Mr-What/Sleipnir/README.md

# Sleipnir
Designs and optimization for 8-legged horse style configuration of Jansen walking linkages

has code and drawings for building chassis for 3D printer or Laser cut.
Also has software used to optimize the Jansen walking linkage for use in the 8-legged horse (Sleipnir) style configuration
