Mr-What/Sleipnir/Drawings/linkage.scad

// for testing and development
//BarHeight=3;LinkRad=3;rad4=1.4;
//include <util.scad>


// test cases
//crankArm(17.5,4.1,4.82,1.48,5.6,4.82,1.48); // for config e
//linkage(44,4,5,1.5,6,5,1.5);
//linkage1(40.36, 10.725, 4.9, 2.7, 2.6, 4.1, 1.5); // BH for e
//monoBracedLinkage(40);Drad=2.4;Frad=7;//ForkHeight=4.3;
//brace(80,8,2.4);

module crankArm(len,h0,r0,d0,h1,r1,d1) difference() {
  linkage(len,h0,r0,d0,h1,r1,d1,sr0=.05,sr1=.2,ar0=.9,ar1=1.4);

  //// add little hole for "cotter-wire" on crank arm
  //translate([0,0,h0/2]) rotate(a=[90,0,0])
  //   cylinder(h=3*r0,r=.8,$fn=80,center=true);

  // for change to using standoffs as axle, counter sink axle screw
  translate([0,0,h0-1.5]) cylinder(h=2.2,r1=rad4,r2=3.3,$fn=24);

  // try another countersink for spindle screw.
  translate([len,0,-0.7]) cylinder(h=2.2,r1=3.3,r2=rad4,$fn=24);
}



// for very short linkages.  Just end nodes, no T bar.
module linkage(len,h0=5,r0=3,d0=1.5,h1=5,r1=3,d1=1.5,
               sr0=-.2,sr1=-.2,ar0=1.2,ar1=1.2) {
echo(str("linkage:",len,",",h0,",",r0,",",d0,",",h1,",",r1,",",d1));
//%linkage(len,h0,r0,d0,h1,r1,d1);

difference() {
  union() {
    translate([len,0,0]) 
       linkNode(r1,h1,ar1,sr1,dx=-3*r1);
       linkNode(r0,h0,ar0,sr0,dx= 3*r0);

    blade([len,0,0.4],3.4,2,    // bar bottom
          [ 0 ,0,0.4],3.4,2);

    blade([len-r1,0,2],1,h1-2.5,   // vertical brace blade
          [    r0,0,2],1,h0-2.5,fn=17);
  }
  drillHole(d0);
  translate([len,0,0]) drillHole(d1);

  translate([-10,-10,-10]) cube([20+len,20,10]);
}}

module monoBracedLinkage(len) difference() {
  union() { //------------------------ EF
    blade([ 0 ,0,0.3],Frad+.3, 2 ,
          [len,0,0.3], 2.5   ,1.6,fn=64);

    // non-braced (BED side) reinforcement 
    translate([len,0,0]) linkNode(Drad+1,4,ar=1.6,dx=-5*Drad);

    linkNode(5,4,ar=.7,off=-.2,dx=2*Frad,dz=2);

    // out-of-plane ridge/brace
    blade([2    ,0,1  ],1,3,
          [len-3,0,0.5],1,3,fn=16);
  }

  for(x=[0,len]) translate([x,0,0]) drillHole(rad4);
  translate([-20,-20,-20]) cube([len+40,40,20]);
}

module linkage2(len,h0,r0,d0,h1,r1,d1) { difference() { union() {
   hull() { barAnchor(1.5*r0);
      cylinder(h=h0,r1=r0+.2,r2=r0-0.2,$fn=48); }
   translate([len,0,0]) { hull() { barAnchor(-1.5*r1);
      cylinder(h=h1,r1=r1,r2=0.4*r1+0.6*d1,$fn=48); }}
   hull() {                cylinder(h=BarHeight,r1=LinkRad+.2,r2=LinkRad-.2,$fn=6);
      translate([len,0,0]) cylinder(h=BarHeight,r1=LinkRad+.2,r2=LinkRad-.2,$fn=6); }
   hull() {                   cylinder(h=h0-0.5,r1=2,r2=.6,$fn=6);
      translate([len-d1,0,0]) cylinder(h=h1-0.5,r1=2,r2=.6,$fn=6); }
   }
   drillHole(d0);
   translate([len,0,0]) drillHole(d1);
}}

module linkage1(len,h0,r0,d0,h1,r1,d1) difference() {
echo("linkage1",len,h0,r0,d0,h1,r1,d1);
  union() {
    translate([len,0,0])
      linkNode(r1,h1,0.6,-.2,dx= -4*r1);
      linkNode(r0,h0,2.6,-.2,dx=2.5*r0);

    blade([ 0 ,0,.4], r0-.2,2.4,
          [len,0,.4],d1+1.5,1.8  );
    
    blade([    d0,0,2],1 ,h0-2,
          [len-r1,0,0],1,BarHeight-.5,fn=17);
  }

  drillHole(d0);
  translate([len,0,0]) drillHole(d1);
  translate([-10,-10,-10]) cube([len+20,20,10]);
}

/*

module brace1(len,h0,r0) {
r1=r0+1.7;
difference() {
  union() {
    difference() { hull() { cylinder(h=3,r1=r1+.1,r2=r1-.1,$fn=48);
      translate([len,0,0]) cylinder(h=3,r1=r1+.1,r2=r1-.1,$fn=48); }
      translate([1.5,0,-1.5]) hull() { cylinder(h=3,r1=r1-1.6,r2=r1-1.4,$fn=6);
             translate([len-1.5,0,0])  cylinder(h=3,r1=r1-1.6,r2=r1-1.4,$fn=6); }}

   translate([len,0,0])
   hull() { cylinder(h=h0,r1=r1+.2,r2=r1-.1,$fn=48);
      translate([-r1-4,0,2]) sphere(r=1,$fn=12); }
   hull() { cylinder(h=h0,r1=r1+.2,r2=r1-.1,$fn=48);
      translate([ r1+4,0,2]) sphere(r=1,$fn=12); }

   translate([0,0,h0/2]) hull() { scale([1,1,h0/2]) sphere(r=1,$fn=12);
            translate([len,0,0])  scale([1,1,h0/2]) sphere(r=1,$fn=12); }
   
   }
   drillHole(r0);
   translate([len,0,0]) drillHole(r0);
}}

*/

module brace(len,h0,r0) difference() {
  union() {
    blade([ len/2,0,.6],r0+2,1.8,
          [-len/2,0,.6],r0+2,1.8);

    for(x=[-1,1]) translate([x*len/2,0,0])
       linkNode(r0+2,h0,ar=0.7*h0/r0,dx=-x*h0*1.5);

     blade([ len/2,0,0],1.6,h0-.3,
           [-len/2,0,0],1.6,h0-.3);
   }

   for(x=[-1,1]) translate([x*len/2,0,0]) drillHole(r0);

   translate([0,0,-5]) cube([len+20,20,10],center=true);
}
