Mr-What/Sleipnir/Drawings/steel/walkerChassis.scad

// config e
Ay=3.318;
AC=17.5;
Bx=53.83;

loY=-60;  // location of lower brace beams
loX= 10;

zBar=90;

$fn=8;

// meter stick for scale
%translate([65,-42,0]) cube([5,100,5],center=true);
%translate([65,0,0]) difference(){
  cube([5,5,140],center=true);
  cube([6,6, 40],center=true);
}

for (a=[-1,1]) {
  %translate([0,0,(zBar-10)*a]) legProxy();
  %translate([0,0,(zBar+10)*a]) legProxy();
  translate( [0,0, zBar    *a]) color([.2,.2,.8,1]) mainBar();
  #translate([0,0,a*(zBar+20)]) rotate([0,90*(a+1),0]) outerCap();
}
basket();

module basket() {
  for(a=[-1,1]) {
    *translate([Bx*a,0,0]) cylinder(r=1,h=120,$fn=16,center=true); // main axle
    for (b=[-1,1]) translate([Bx*b,0,zBar*a]) {
       color([0,0,1,.6]) translate([0,0,-6*a])
       cylinder(r=1.9,h=60,$fn=16,center=true); // axle

       // axle brace sleves
       translate([0,0,-26*a]) cylinder(r=2.5,h=18,$fn=16,center=true);
    }

    //color([.6,.8,0,1]) 
    translate([loX*a,loY,0]) difference() { 
       cube([2.5,2.5,230],center=true); // lower rails

       // remove center section for wide platform version
       cube([3,3,78.5],center=true);
    }

    hull() for (b=[-1,1]) translate([ Bx*b, 0 ,71*a]) sphere(1); // arm guard bar
    //hull() for (b=[-1,1]) translate([loX*b,loY,71*a]) sphere(1); // outer foot bar
    for (b=[-1,1]) {
      hull() { // outer diagonal
        translate([ Bx*b, 0  ,70*a]) sphere(1);
        translate([20*b,loY+2,70*a]) sphere(1);
      }
    }

    for(x=[-1,1]) {
       hull() { // inner back trap
         translate([x*36    ,loY+2,28*a]) sphere(1);
         translate([x*(Bx+1),  1  , 5*a]) sphere(1);
       }
       hull() { // outer back
         translate([x*36,loY+1,40*a]) sphere(1);
         translate([x*Bx,  0  ,60*a]) sphere(1);
       }
    }

    // may do something more complicated for payload bay,
    // but for now, just stich sides together
    translate([a*(Bx+1),1,0]) difference() {
       cube([3.8,3.8,140],center=true);
       translate([-.5*a,-.5,0]) cube([3.8,3.8,141],center=true);
    }

    translate([34*a,loY+2.7,0]) difference() {
       cube([2.5,2.5,138],center=true);
       translate([-.4*a,.4,0]) cube([2.5,2.5,139],center=true);
    }
    translate([0,loY+3,67*a]) rotate([0,90*(a+1),0]) difference() {
       cube([70,3.8,3.8],center=true);
       translate([0,.4,.4]) cube([72,3.8 ,3.8],center=true);
    }
    hull() {  // central floor cross
      translate([ 34*a,loY+1, 38]) sphere(1);
      translate([-34*a,loY+1,-38]) sphere(1);
    }
  }

  //for(z=[-1,0,1])
  for(z=[-1,1])
  translate([0,loY+.4,40*z]) rotate([0,(z==1)?180:0,0]) difference() {
     cube([70,2.5,2.5],center=true);
     translate([0,-.4,-.4]) cube([71,2.5,2.5],center=true);
  }
  translate([0,loY+2,0]) rotate([90,0,0]) cylinder(r=4,h=.4,$fn=32);
  color([0,.2,.8,.2]) // expanded mesh floor
     translate([0,loY+2,0]) cube([68,.5,134],center=true);
     //translate([0,loY+2,0]) cube([2*loX,1,130],center=true);
}

module mainBar() {
  cube([110,5,5],center=true);
  translate([0,Ay,0]) {
    cylinder(r=1.5,h=4,$fn=16,center=true);
    #cylinder(r=AC,h=2,$fn=36,center=true);
    //cylinder(r=AC+2,h=.4,$fn=36,center=true);
  }

  // lower support
  for(x=[-1,1]) {
     // lower rail tubes
     translate([x*loX,loY,0]) cube([3.8,3.8,10],center=true);

     hull() {     // diagonals
       translate([x*(loX+2),loY,0]) sphere(1);
       translate([x*(Bx-8),0,0]) sphere(1);
     }
  }
  translate([0,loY,0]) cube([2*loX,3.8,3.8],center=true);
}

module outerCap() {
  for (b=[-1,1]) translate([Bx*b,0,-1]) {
     // axle brace sleves... shorter on outside
     cylinder(r=2.5,h=6 ,$fn=16,center=true);
  }
  translate([0,loY,0]) cube([2*loX,3.8,3.8],center=true);
  for(x=[-1,1]) translate([x*loX,loY,1])
         cube([3.8,3.8,8],center=true); // lower rail sleves

  for (b=[-1,1]) hull() { // outside diagonal brace
    translate([loX*b,loY,0]) sphere(1);
    translate([ Bx*b, 0 ,0]) sphere(1);
  }
  hull() for(b=[-1,1]) translate([Bx*b,0,0]) sphere(1);
}

module legProxy() scale([1,1,12]) {
  legProxy1();
  mirror([1,0,0]) legProxy1();
}

// measurements from drawing, center pixel 600,300, 4 pixels/cm
module legProxy1() difference() {

  union() { hull() {
    translate([0,3.32,0]) cylinder(r=17.5+2,h=1,$fn=36,center=true);
    translate([-250/4, 290/4,0]) node();
    translate([-200/4, 290/4,0]) node();
    translate([-360/4, 120/4,0]) node();
    translate([-500/4,-110/4,0]) node();
    translate([-430/4,-230/4,0]) node();
  }
  hull() {
    translate([-400/4,-220/4  ,0]) node();
    translate([-340/4,-370/4+2,0]) node();
    translate([ -90/4,-370/4+2,0]) node();
    translate([-140/4,-120/4  ,0]) node();
  }}

  // cut out to show step height
  translate([-50,-92+5,-1]) cube([3,17.5-5,2]);
}

module node() cylinder(r=2,h=1,$fn=9,center=true);
