Mr-What/Sleipnir/(list of files, cad)

Other CAD files:
Drawings/JansenAssembly.scad
