Mr-What/Sleipnir/(commit log)

2015-09-08 re-building from old SVN repo
    [Jansen.scad, JansenBED.scad, JansenDefs.scad, JansenFoot.scad, JansenMain.scad, Klann.scad, basketMount.scad, driveElectronicsMount.scad]
2015-09-10 reduce fuzz for spread around holes. current printer does not spread that much
    [Jansen.scad]
2015-09-10 beef up support for printability under cura
    [JansenBED.scad]
2015-09-10 tighten up for newer, lower spread printer
    [motorMount.scad]
2015-09-17 make B node on BH a little thicker. Want to get leg assembles a little farther from main bar
    [Jansen.scad]
2015-09-17 more bracing at fork
    [JansenBED.scad]
2015-09-17 make support wall a little thicker for cura
    [JansenFoot.scad]
2015-09-17 made L298N module mounts a little closer to walls. raise top platform a bit to clear L298N heatsink
    [driveElectronicsMount.scad]
2015-09-28 added (optional) cuts to fit motor gear onto "bobbin" hub
2015-09-29 make small end of BH a little thinner, to allow nylock to lock using 1 inch screw for H node.
    [Jansen.scad]
2015-09-29 seems to work OK on kebab skewers. might need larger for proper 3/16" diameter rod or tube
    [pinchCap.scad]
2015-12-02 tried to make H node a bit thinner. Also trying to bring legs in a little closer to main bar to save width
    [Jansen.scad]
2015-12-02 added motor group demo display. made main drive pulley larger, but with pass-through for crank-arm screw
    [Jansen.scad, pulley.scad]
2015-12-03 initial design. checking in before changing a bit
    [payloadMount.scad]
2015-12-03 added platform and mounting tabs
    [payloadMount.scad]
2015-12-03 tweaking platform mount
    [payloadMount.scad]
2015-12-03 more mount tweaks
    [payloadMount.scad]
2015-12-03 checking in before making tabs a bit bigger
    [payloadMount.scad]
2015-12-03 larger platform tabs, with pilot holes for optional screws
    [payloadMount.scad]
2015-12-04 liked snap-on upper platform so much, changed lower to use a similar platform
    [payloadMount.scad]
2015-12-04 recess lower tabs a bit
    [payloadMount.scad]
2015-12-04 make moving connections to B axles a little looser
    [Jansen.scad, JansenBED.scad, JansenMain.scad]
2015-12-06 made B node on BH a little fatter
    [Jansen.scad]
2015-12-06 moved link up a bit from foot to make a bit of an ankle
    [JansenFoot.scad]
2015-12-08 made lit a bit bigger, with more rounded corners
    [payloadMount.scad]
2015-12-10 adding x pegs. check in before altering a bit
    [payloadMount.scad]
2016-01-02 more details, and split main assembly instructions to 3D folder
2016-01-02 draft for revision of 3D printed version instructions
2016-01-02 moved motor down 1cm. belts could have been tighter
    [motorMount.scad]
2016-01-03 made motor pulley a little "rough" to act like teeth. It has had trouble slipping on the belt
    [Jansen.scad, pulley.scad]
2016-01-03 reduce seperation on main brace
    [JansenMain.scad]
2016-01-03 rounded corners on some parts
    [Jansen.scad]
2016-01-03 seperated out some modules. rounded edges on crankLink
    [Jansen.scad, crankLink.scad, linkage.scad]
2016-01-05 put some useful small modules in an easier file to include
    [util.scad]
2016-01-06 rounding edges
    [Jansen.scad, crankLink.scad, linkage.scad, util.scad]
2016-01-06 rounded more pieces. especially BED
    [Jansen.scad, JansenBED.scad, linkage.scad, util.scad]
2016-01-08 changes to main bar bracing. try to make it stiffer
    [JansenMain.scad, motorMount.scad]
2016-01-08 more clearance for new main bar bracing blades
    [motorMount.scad]
2016-01-09 checking fit of main-bar connectors
    [Jansen.scad, JansenMain.scad]
2016-01-09 beefed up rails. DE was a bit flexy
    [JansenBED.scad]
2016-04-11 draft for support structure in steel version
    [walkerChassis.scad]
2016-04-11 checking in before changing to have braces under main bar
    [walkerChassis.scad]
2016-04-11 completed first version of 5 part assembly
    [walkerChassis.scad]
2016-04-11 added color coding on assemblies
    [walkerChassis.scad]
2016-04-11 convert to actual angle beams for floor frame
    [walkerChassis.scad]
2016-04-17 notional drawing for leg assembly in steel. has kinematic solution
2016-04-18 corrected kinematics
    [legAssembly.scad]
2016-04-18 minor bug fixes and details.
    [legAssembly.scad]
2016-04-18 change to use $t for animations
    [legAssembly.scad]
2016-04-23 minor tweaks
    [legAssembly.scad]
2016-04-25 added animation of full assembly
    [Jansen.scad]
2016-04-25 removed assembly code to another file
    [Jansen.scad, JansenAssembly.scad]
2016-06-12 checking in before making knee wider
    [legAssembly.scad]
2016-06-13 re-design for wider knee (F) joint
    [legAssembly.scad]
2016-07-25 changing to use mostly flanged bearings, and rod-end (heim) joints in progress...
    [legAssembly.scad, util.scad]
2016-07-25 more details on hinges, plans for bushing at axle
    [legAssembly.scad]
2016-07-26 improved CH clearance at H node on BH segments
    [legAssembly.scad]
2016-08-06 checking in before trying to mount 698 bearings on pedal spindle closer
    [legAssembly.scad, walkerChassis.scad]
2016-08-06 looks like old changes for rounder parts were never committed?
    [JansenFoot.scad, linkage.scad]
2016-08-06 older changes with move to rounder parts, never committed?
    [motorMount.scad, util.scad]
2016-08-06 months old changes, not committed?
    [payloadMount.scad]
2016-08-06 tweaked spacings around F698 bearings a bit.
    [legAssembly.scad]
2016-08-06 move to channelFork on hip
    [legAssembly.scad]
2016-08-09 proper drawings for 25x37x7 bearings on B-axle
    [legAssembly.scad]
2016-09-01 change to female Heim rod-ends, SI8 T/K, on a headless bolt. The females seem to be a little "beefier", and I think it will be easier to weld to cut-off bolts, than to weld or tap to tubes. We will b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
    [legAssembly.scad, util.scad]
2016-09-02 minor tweaks. check in before drawing bolted H fork on foot
    [legAssembly.scad, util.scad]
2016-09-03 try a square tube at Hamstring for foot triangle. This might be easier to fabricate
    [legAssembly.scad]
2016-09-03 going back to thin knee
    [legAssembly.scad]
2016-09-03 simplified build a bit, using square tubes instead of additional forks
    [legAssembly.scad]
2016-09-07 back to square tubes on BH
    [legAssembly.scad]
2016-09-07 rotated foot H fork a bit
    [legAssembly.scad]
2016-10-18 added jig drawings
    [legAssembly.scad, util.scad]
